MohamadDasuki/Soil_Moisture_Sensor/README.md

# Soil Moisture Sensor

Button-activated, battery-powered soil moisture meter with a 0.96" OLED display.

Press the button -> MCU wakes -> load switch powers the OLED and sensor -> moisture reading is shown for 15 s -> everything powers down (<1 uA standby).

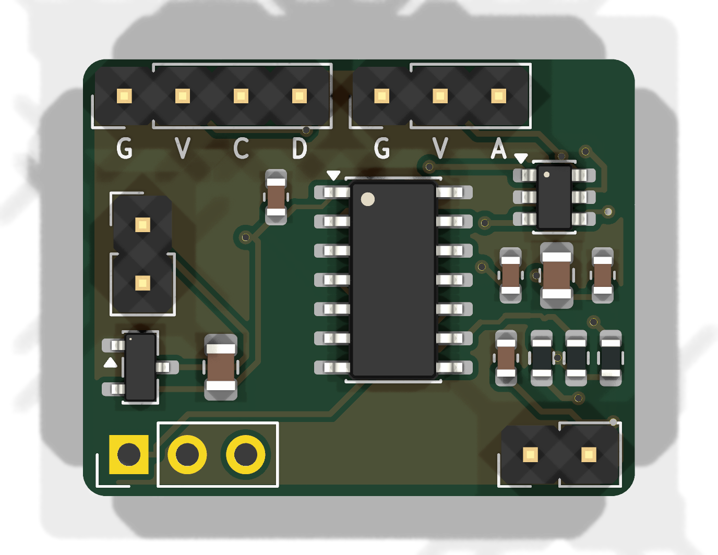
[picture p1: docs/pcb_top.png]
PCB top


## Hardware
| Ref | Function | Part |
|---|---|---|
| U1 | MCU | Microchip ATtiny1614-SSNR (SOIC-14) |
| J5 | Battery | 3xAAA holder, leads soldered to J5 pads (+ = pin 1; direct, 3.0-4.8 V) |
| Q1 | Reverse-polarity protection | AOS AO3401A P-FET |
| U2 | Peripheral power switch | TI TPS22917DBVR load switch |
| J2 | Display | ELEGOO 0.96" SSD1306 I2C OLED (0x3C) - 2.54 mm pads, GND-VCC-SCL-SDA |
| J3 | Sensor | DIYmall capacitive soil sensor v1.2 (analog) - 2.54 mm pads, GND-VCC-AOUT |
| SW1 | Button | Twidec PBS-110 7 mm panel-mount momentary, leads soldered to 2 pads |
| J1 | Programming | UPDI through-hole pads on the board edge (UPDI-GND-VCC) |

See `BOM.csv` for the full parts list and `Moisture_Sensor.pdf` for the schematic.

## PCB (rev C)
- 24 x 19 mm, 2-layer, 1.6 mm, all SMD on top, GND pour both sides.
- Top edge: OLED (G V C D) and sensor (G V A) pads. Bottom edge: UPDI (U G V) and button pads.
- Solder the supplied Dupont/PH cables directly to the pads (or fit 2.54 mm headers).
- No mounting holes: hold the board with a ledge/snap clips. `Moisture_Sensor.step` is provided for enclosure design.

## Programming
UPDI via a 3.3 V USB-serial adapter with a 4.7k resistor TX->UPDI, RX->UPDI ("SerialUPDI"), or an Adafruit UPDI Friend.
Arduino IDE + megaTinyCore, board ATtiny1614, programmer SerialUPDI. Remove batteries when powering from the programmer.

## Pin map (ATtiny1614)
| Signal | Port | Pin |
|---|---|---|
| LOAD_EN | PA4 | 2 |
| AOUT (sensor, ADC) | PA5 | 3 |
| BTN (wake) | PA6 | 4 |
| SDA | PB1 | 8 |
| SCL | PB0 | 9 |
| UPDI | PA0 | 10 |

## Firmware

`firmware/MoistureMeter/` contains an Arduino sketch for megaTinyCore. It uses 4.7 KB of flash and 75 B of RAM, and needs no external libraries. The SSD1306 driver in `oled.h` is buffer-less (text only).

**Operation**
- **Idle:** the MCU is in power-down and the load switch is off (well under 1 µA).
- **Press the button:** the OLED and sensor power up and the battery voltage is checked. The display then shows a live moisture % reading, refreshed every second, with a status line (DRY / OK / WET) and a bar graph. After 15 s it powers everything off.
- **Short press while on:** restarts the 15 s timer.
- **Hold 3 s while on:** starts calibration. Follow the prompts: sensor in air, press; sensor in water up to the line, press. The values are saved to EEPROM.
- **Battery below 3.1 V:** shows "BATTERY EMPTY" instead of a reading. Below 3.4 V, the header shows "LOW BAT".
- **Battery voltage:** measured by reading the internal 1.1 V reference against VDD, so no divider is needed. The sensor is read ratiometrically (ADC reference = VDD), so battery droop cancels out.

**Build and flash**
- Arduino IDE: add the board manager URL `http://drazzy.com/package_drazzy.com_index.json` and install **megaTinyCore**.
- Tools settings: Chip **ATtiny1614**, Clock **5 MHz internal**, BOD **Disabled/Disabled**, millis timer **default (not RTC)**, Programmer **SerialUPDI**.
- Run **Burn Bootloader** once (this only sets fuses), then **Upload Using Programmer**.
- With arduino-cli, use the FQBN `megaTinyCore:megaavr:atxy4:chip=1614,clock=5internal,bodmode=disabled`.

Calibration defaults are typical v1.2 values (dry ≈ 600/1023, wet ≈ 280/1023). Calibrate once per sensor for accurate readings.
## Ordering (JLCPCB)

The `fab/` folder holds everything needed to order the board:

| File | Upload as |
|---|---|
| `Moisture_Sensor_gerbers_JLCPCB.zip` | Gerber file (2 layers, 24 × 19 mm, 1.6 mm FR-4) |
| `BOM_JLCPCB.csv` | PCB Assembly → BOM (LCSC part numbers) |
| `CPL_JLCPCB.csv` | PCB Assembly → CPL (pick and place) |

- **Assembly:** top side only, SMD parts only. J1, J2, J3, J5 and SW1 are hand-soldered wire pads and aren't placed.
- **Before confirming,** check pin 1 of U1, U2 and Q1 in JLCPCB's placement preview. The CPL applies the usual rotation offsets for SOT-23 and SOIC parts.
- **Regenerating:**
  - CPL and JLCPCB BOM: run `tools/gen_cpl.py` with KiCad's Python.
  - Gerbers and drill files: export with `kicad-cli pcb export gerbers` (subtract soldermask, no X2) and `kicad-cli pcb export drill` (Excellon, mm, separate PTH/NPTH).
## Enclosure

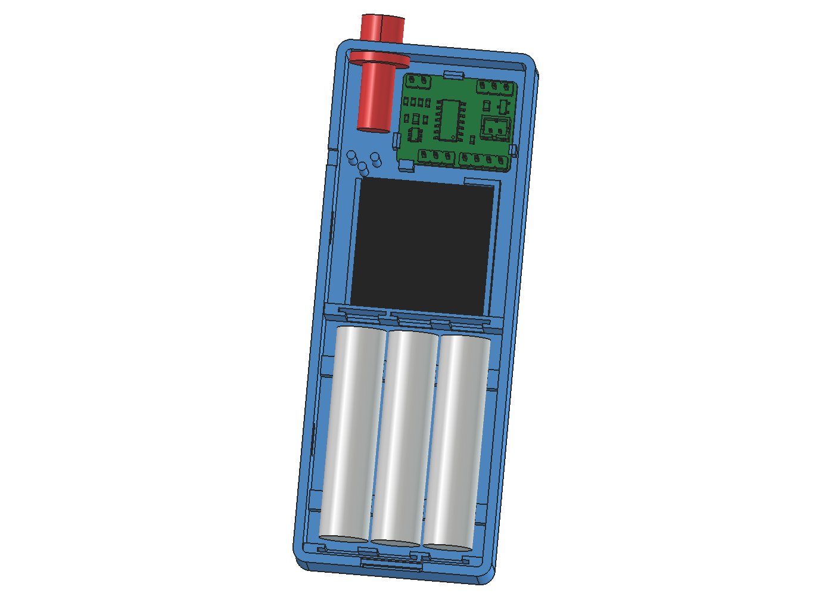
[picture p2: docs/enc_inside.png]
Inside


| | |
|---|---|
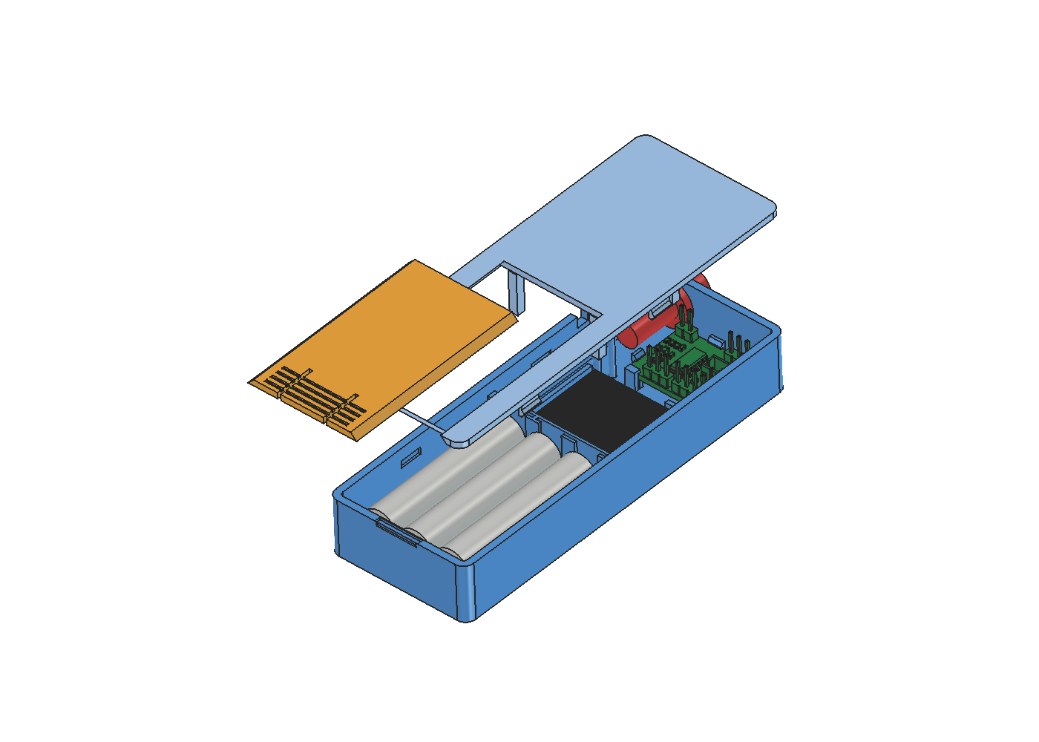
[picture p3: docs/enc_exploded.png]
Exploded
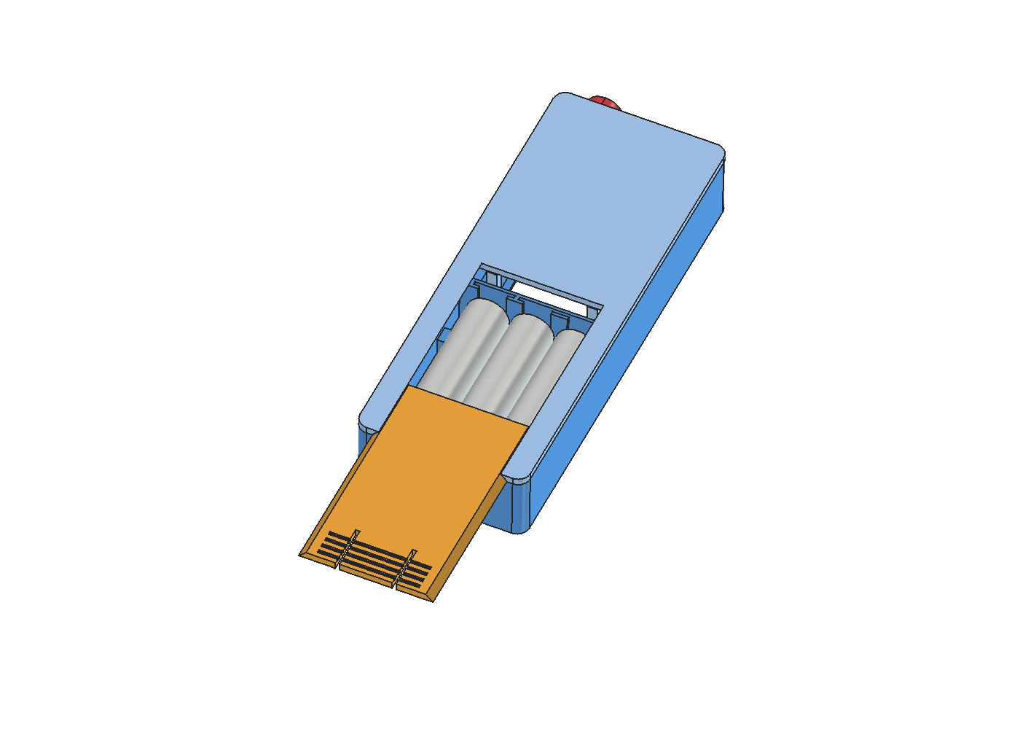
[picture p4: docs/enc_door_open.png]
Battery door
|  |  |
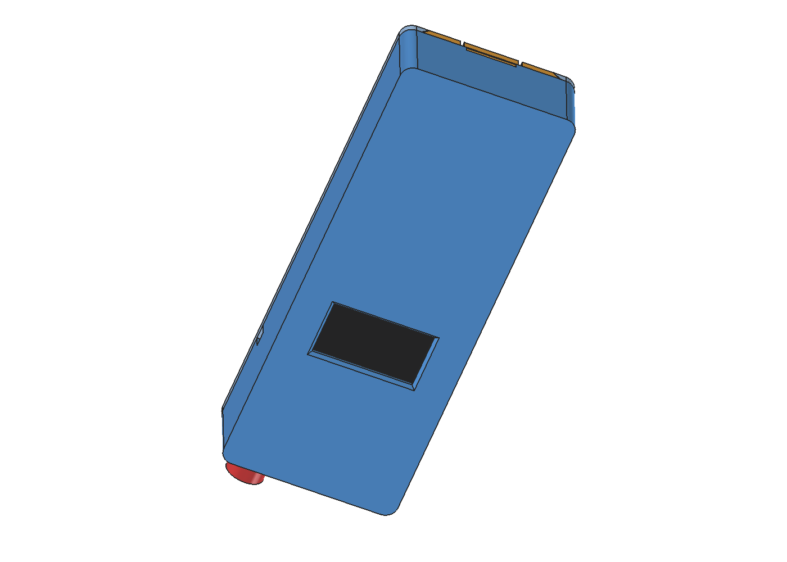
[picture p5: docs/enc_front34.png]
Front
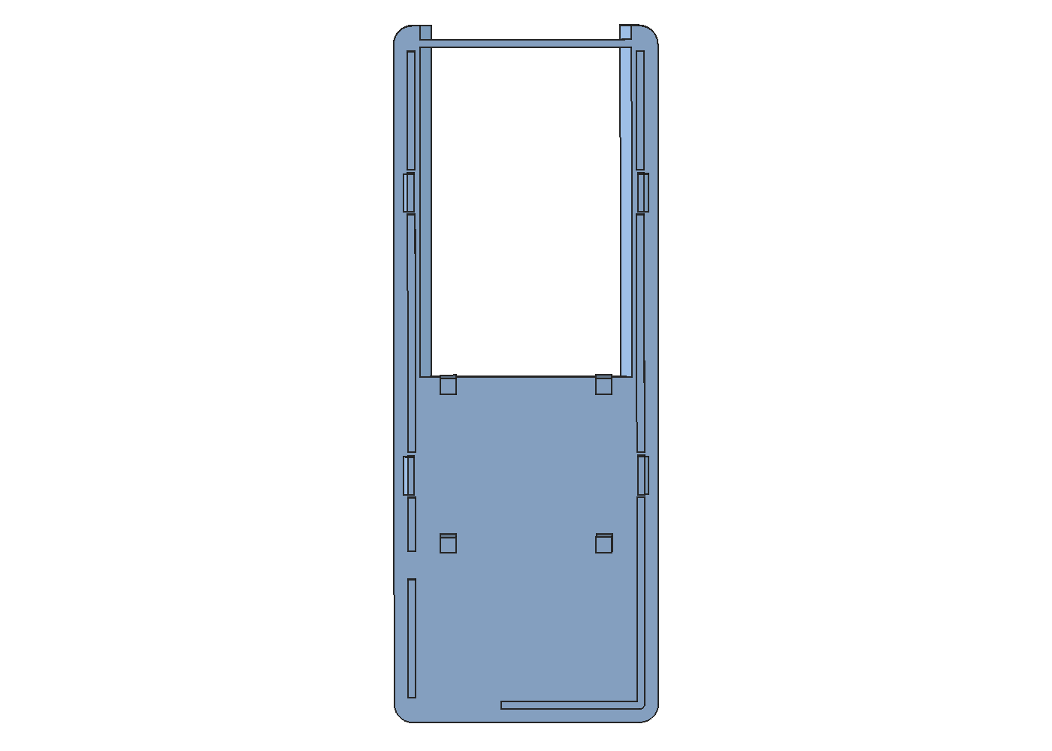
[picture p6: docs/enc_lid_under.png]
Lid underside
|  |  |

Outer size **42 × 111 × 18.4 mm**. Generated by `tools/gen_enclosure.py`, which is fully parametric (run it with FreeCAD's `freecadcmd.exe`). The script also checks for interference against the real PCB STEP model and against dummy models of the OLED, the AAA cells and the button. `tools/render_enclosure.py` (run with `freecad.exe`) regenerates the images.

| Part | File | Print orientation |
|---|---|---|
| Body (tub) | `enclosure/body.stl` | display face down, as exported |
| Lid | `enclosure/lid.stl` | outer face down, as exported |
| Battery door | `enclosure/door.stl` | outer face down, as exported |

**Printing:** no supports are needed. The button hole is a teardrop, the display window has a 45° chamfer, the clip lips overhang by 0.5 mm or less, and the door rails are 45° dovetails. Use 0.2 mm layers, 3–4 perimeters, and **PETG** (recommended for the snap clips). PLA works, but the clips run at about 3 % strain.

**Features**
- **Display:** a window in the front face. The module drops into a pocket with corner ledges, and the lid has 4 posts that clamp the module's corners.
- **PCB:** held by 3 flexible snap clips plus 1 rigid hook, on 3 mm standoffs. To insert it, tilt the board and slide its J2/J3 edge (toward the display) under the rigid hook, then press the other edge down until the clips snap.
- **Button:** a 7 mm hole in the top end wall. The nut tightens from inside.
- **Sensor cable:** a U-notch in the side wall at the lid seam, so the cable is laid in rather than threaded. Weave the cable around the 3 posts for strain relief.
- **Batteries:** 3×AAA side by side behind a sliding dovetail door. To open it, lift the flex tab at the finger grooves and slide the door out toward the bottom end.
  - Contacts are generic AAA plates/springs in 0.8 mm slots: a single plate for 10 mm-wide contacts, a double slot for 21 mm-wide bridging contacts.
  - Top fence: single (+, cell 1, left) and double (cells 2/3).
  - Bottom fence: double (cells 1/2) and single (−, cell 3).
  - Solder the + and − wires to the J5 pads (B+ / B− on the back silkscreen).
- **Lid:** snap-fit with 4 tabs; no screws. Open it only for programming (the UPDI pads are reachable with the lid off).

**Verify before printing** (all are parameters at the top of `gen_enclosure.py`):
- OLED glass and viewing-area offsets (`GLASS_*`, `VIEW_*`).
- Button body length (the space behind the wall is about 18 mm).
- Contact plate dimensions.
- Rebuild after any change.
## Notes
- Sensor: bypass its onboard 662K LDO (the NE555 is otherwise starved at 3.3 V). Its output then scales with supply, so read it ratiometrically (ADC reference = VDD). Calibrate dry/wet values in firmware.
- OLED runs from VSW through its own LDO (3.3-5 V); no mod needed.
- Firmware: 10 MHz is fine (>2.7 V); set I2C pins high-Z before switching off VSW; low-battery cutoff ~3.3 V.
- `tools/gen_sch.py` regenerates the schematic and `tools/gen_pcb.py --route` the PCB (KiCad's bundled Python; routing needs Freerouting + Java 25).
