MohamadDasuki/Soil_Moisture_Sensor/docs/pcb_bottom.png

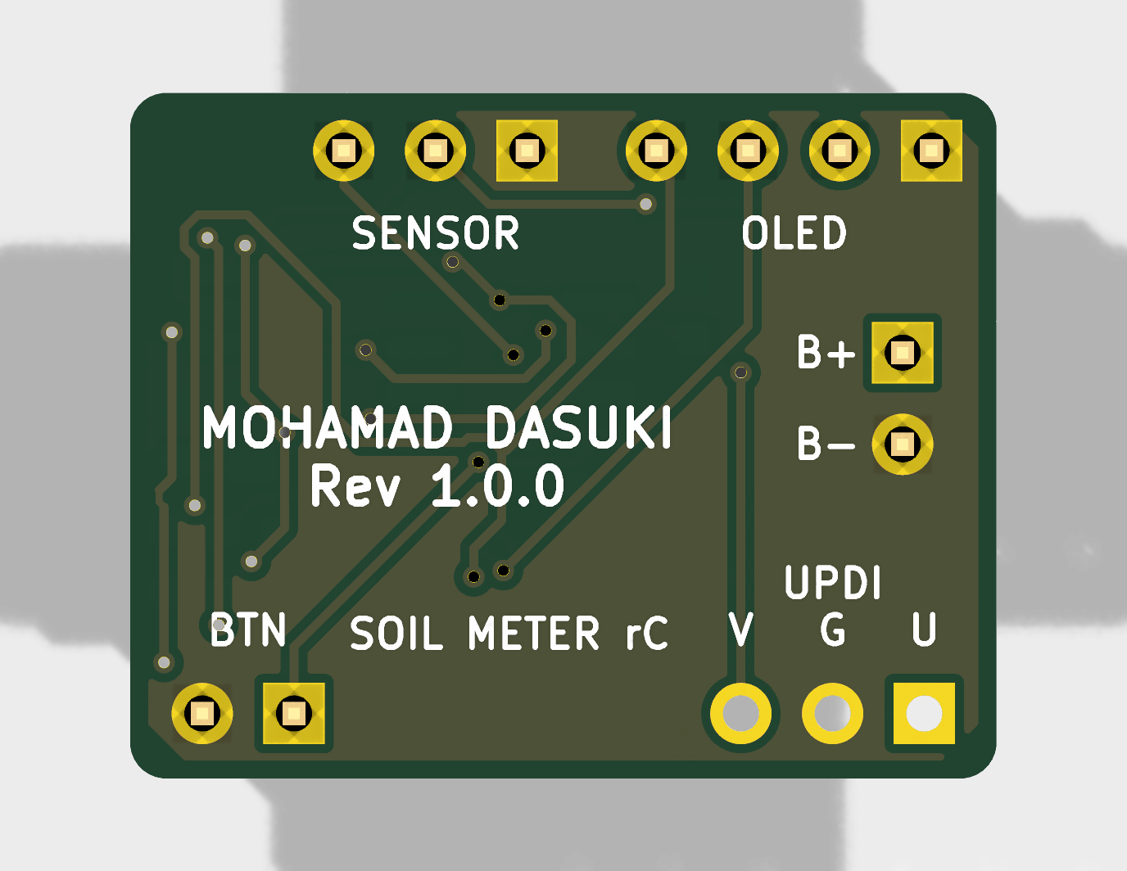
docs/pcb_bottom.png
