MohamadDasuki/Soil_Moisture_Sensor/BOM.csv

Reference | Value | Footprint | MPN | Manufacturer | LCSC | QUANTITY | DNP
C1 | 10uF 25V X5R | Capacitor_SMD:C_0805_2012Metric | CL21A106KAYNNNE | Samsung | C15850 | 1
C2,C5,C6 | 100nF | Capacitor_SMD:C_0603_1608Metric | CC0603KRX7R9BB104 | Yageo | C14663 | 3
C3 | 1nF | Capacitor_SMD:C_0603_1608Metric | CL10B102KB8NNNC | Samsung | C1588 | 1
C4 | 22uF 25V X5R | Capacitor_SMD:C_0805_2012Metric | CL21A226MAQNNNE | Samsung | C45783 | 1
J1 | UPDI | Connector_PinHeader_2.54mm:PinHeader_1x03_P2.54mm_Vertical |  |  |  | 1 | DNP
J2 | OLED SSD1306 0.96in | Connector_PinHeader_2.54mm:PinHeader_1x04_P2.54mm_Vertical | Supplied Dupont wires soldered to pads (opt. 1x04 2.54mm header) | - |  | 1
J3 | SOIL SENSOR v1.2 | Connector_PinHeader_2.54mm:PinHeader_1x03_P2.54mm_Vertical | Supplied PH2.0-3P to Dupont cable soldered to pads | DIYmall |  | 1
J5 | BATTERY 3xAAA | Connector_PinHeader_2.54mm:PinHeader_1x02_P2.54mm_Vertical | 3xAAA holder leads soldered to pads | - |  | 1
Q1 | AO3401A | Package_TO_SOT_SMD:SOT-23 | AO3401A | Alpha & Omega | C15127 | 1
R1,R2 | 10k | Resistor_SMD:R_0603_1608Metric | 0603WAF1002T5E | UNI-ROYAL | C25804 | 2
R3 | 0R | Resistor_SMD:R_0603_1608Metric | 0603WAF0000T5E | UNI-ROYAL | C21189 | 1
SW1 | READ BUTTON | Connector_PinHeader_2.54mm:PinHeader_1x02_P2.54mm_Vertical | PBS-110-XBK | Twidec |  | 1
U1 | ATtiny1614-SSNR | Package_SO:SOIC-14_3.9x8.7mm_P1.27mm | ATTINY1614-SSNR | Microchip | C481364 | 1
U2 | TPS22917DBVR | Package_TO_SOT_SMD:SOT-23-6 | TPS22917DBVR | Texas Instruments | C2681320 | 1
