MohamadDasuki/Soil_Moisture_Sensor/enclosure/assembly.step

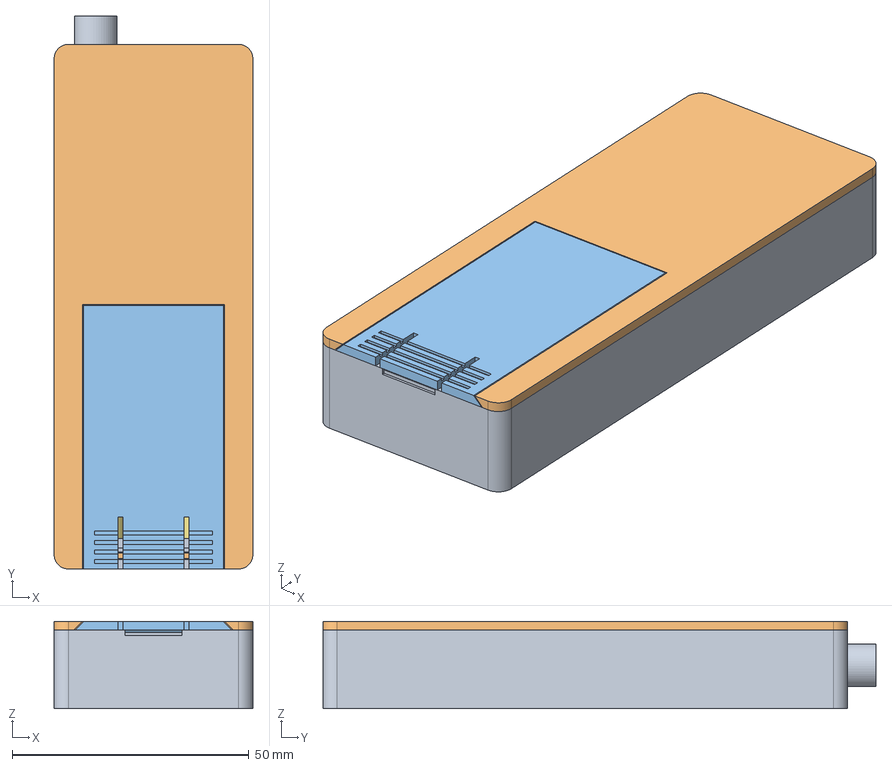
[picture p8: CAD file, 2026-10-27]
enclosure/assembly.step
42.0 x 116.9 x 18.4 mm
