MohamadDasuki/Soil_Moisture_Sensor/Moisture_Sensor.step

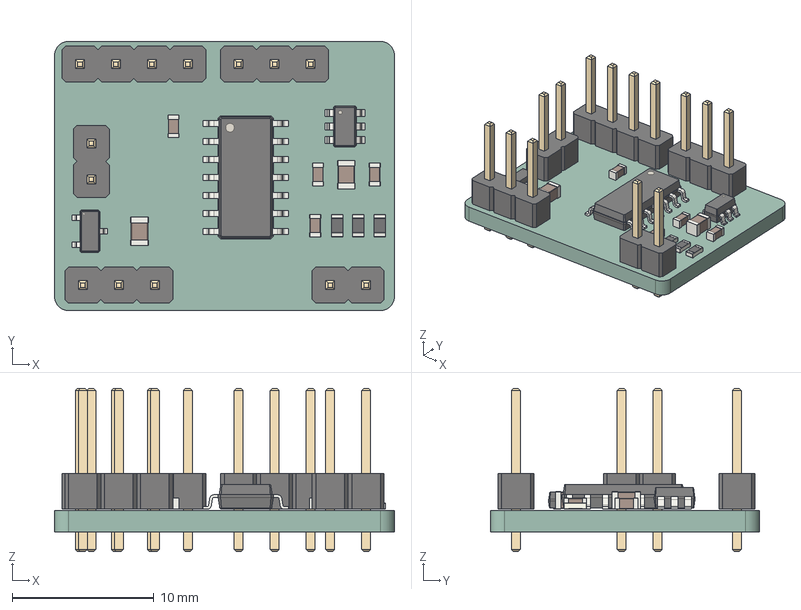
[picture p9: CAD file, 2026-10-27]
Moisture_Sensor.step
24.0 x 19.0 x 11.5 mm
SOT-23
SOIC-14_3.9x8.7mm_P1.27mm
PinHeader_1x02_P254mm_Vertical x 2
C_0603_1608Metric x 4
SOT-23-6
R_0603_1608Metric x 3
C_0805_2012Metric x 2
PinHeader_1x03_P254mm_Vertical x 2
PinHeader_1x04_P254mm_Vertical
Moisture_Sensor_PCB
