MohamadDasuki/Soil_Moisture_Sensor/enclosure/door.step

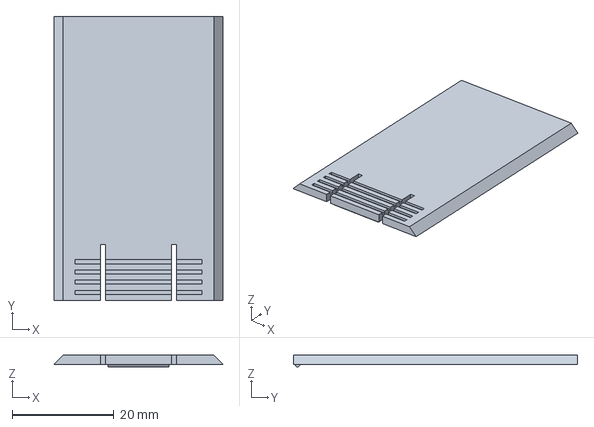
[picture p10: CAD file, 2026-10-27]
enclosure/door.step
33.1 x 55.7 x 2.30 mm
