MohamadDasuki/Soil_Moisture_Sensor/enclosure/lid.step

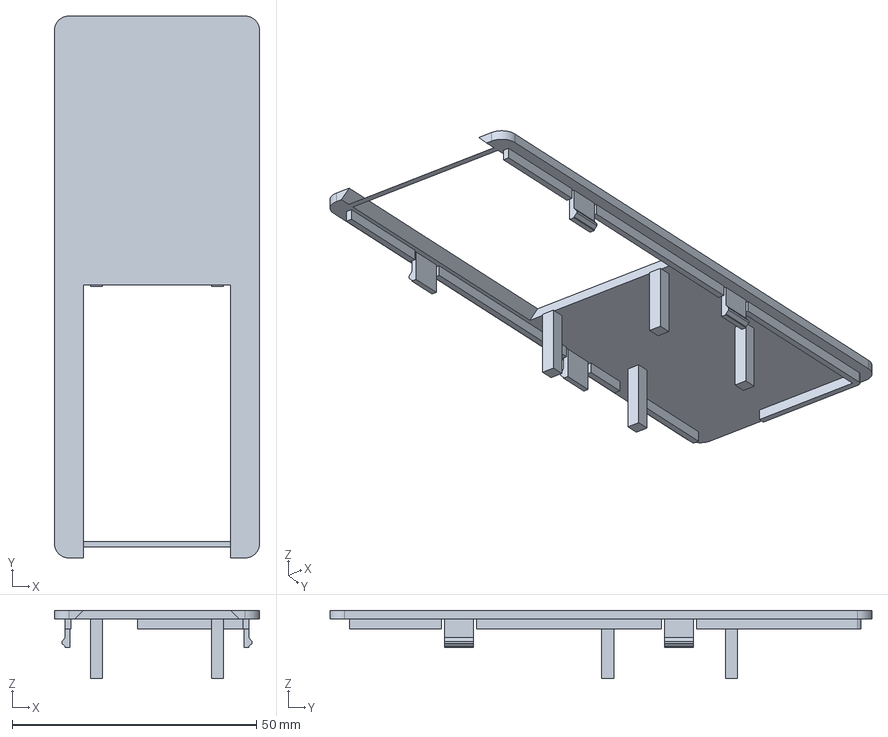
[picture p11: CAD file, 2026-10-27]
enclosure/lid.step
42.0 x 110.9 x 14.0 mm
