MohamadDasuki/Soil_Moisture_Sensor/enclosure/body.step

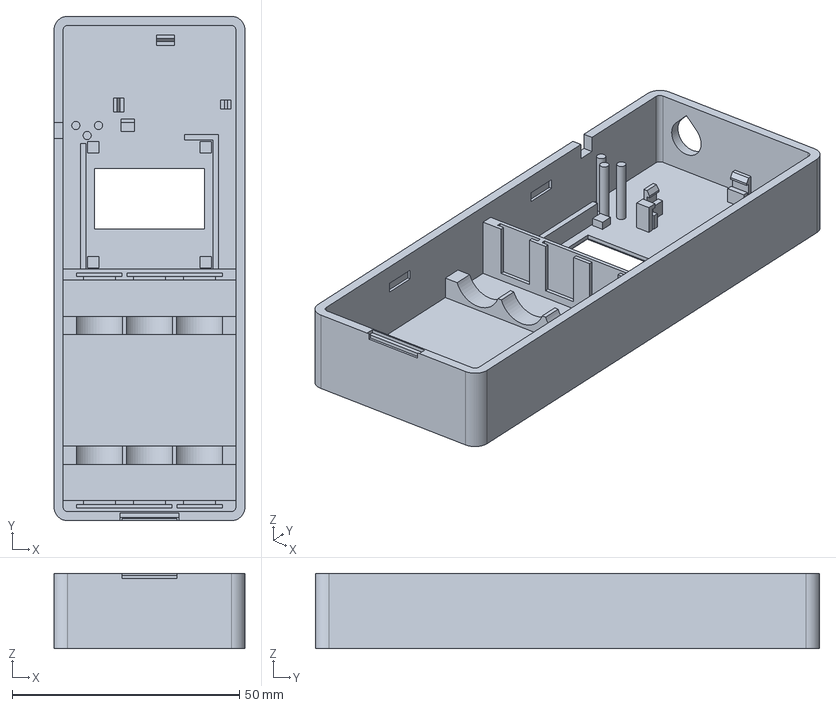
[picture p12: CAD file, 2026-10-27]
enclosure/body.step
42.0 x 110.9 x 16.6 mm
