MohamadDasuki/Soil_Moisture_Sensor/(list of files, cad)

Other CAD files:
enclosure/body.stl
enclosure/door.stl
enclosure/lid.stl
