MohamadDasuki/Soil_Moisture_Sensor/Moisture_Sensor.kicad_pcb

## KiCad design Moisture_Sensor.kicad_pcb (2026-10-27)

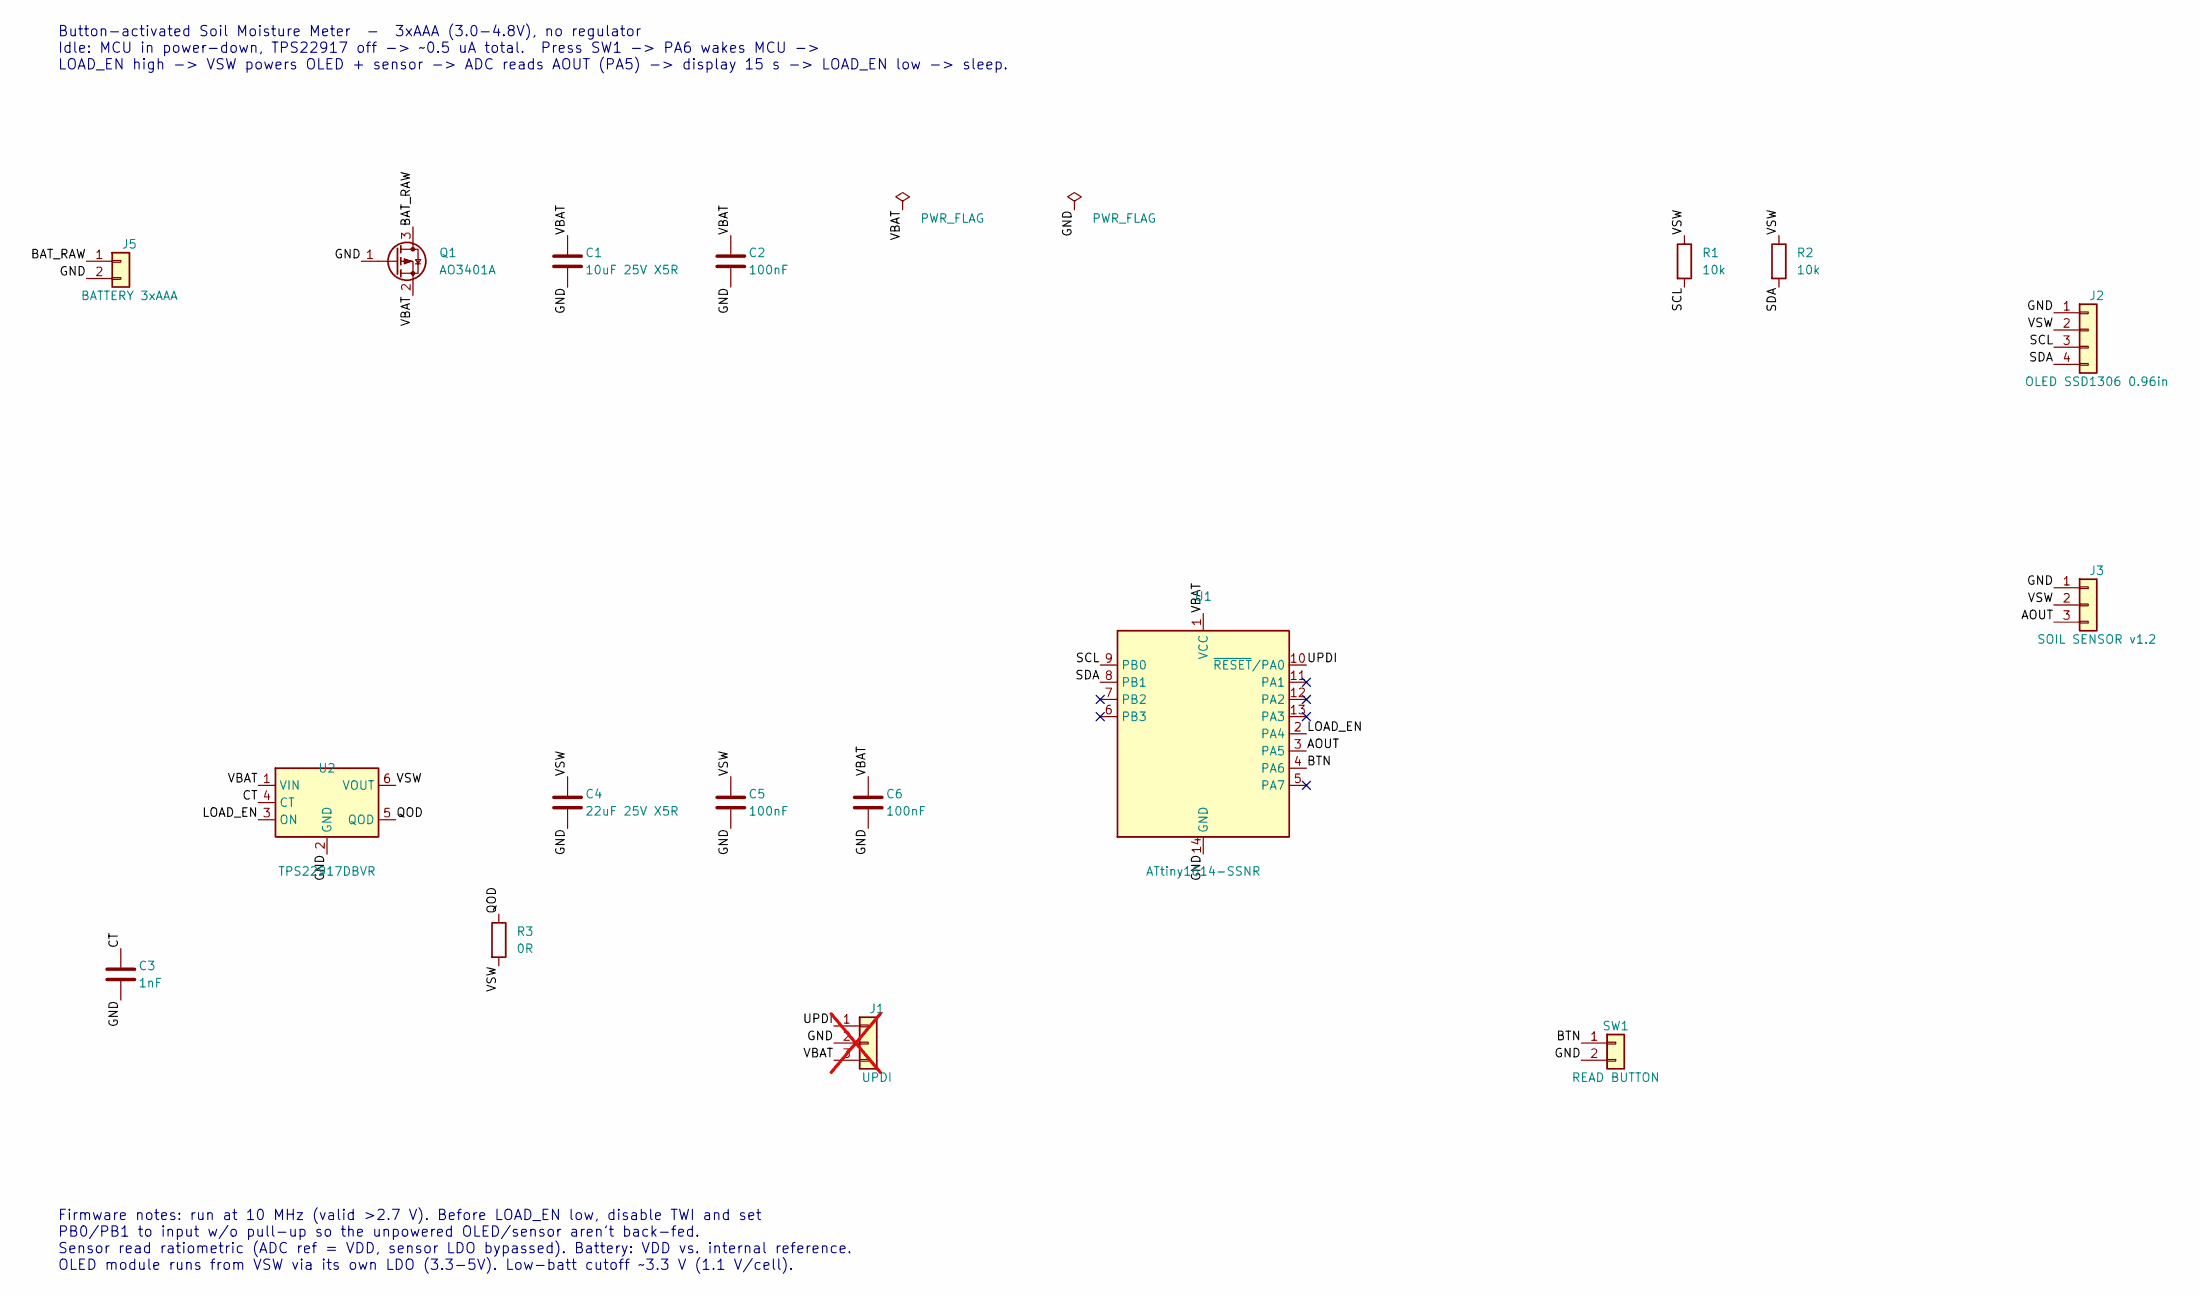
[picture p14: schematic Moisture_Sensor.kicad_sch, Soil Moisture Meter]

Parts:
C1: 10uF 25V X5R; C_0805_2012Metric; MPN CL21A106KAYNNNE; LCSC C15850
C2, C5, C6: 100nF; C_0603_1608Metric; MPN CC0603KRX7R9BB104; LCSC C14663
C3: 1nF; C_0603_1608Metric; MPN CL10B102KB8NNNC; LCSC C1588
C4: 22uF 25V X5R; C_0805_2012Metric; MPN CL21A226MAQNNNE; LCSC C45783
J1: UPDI; PinHeader_1x03_P2.54mm_Vertical; not fitted
J2: OLED SSD1306 0.96in; PinHeader_1x04_P2.54mm_Vertical; MPN Supplied Dupont wires soldered to pads 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
J3: SOIL SENSOR v1.2; PinHeader_1x03_P2.54mm_Vertical; MPN Supplied PH2.0-3P to Dupont cable solde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
J5: BATTERY 3xAAA; PinHeader_1x02_P2.54mm_Vertical; MPN 3xAAA holder leads soldered to pads
Q1: AO3401A; SOT-23; MPN AO3401A; LCSC C15127
R1, R2: 10k; R_0603_1608Metric; MPN 0603WAF1002T5E; LCSC C25804
R3: 0R; R_0603_1608Metric; MPN 0603WAF0000T5E; LCSC C21189
SW1: READ BUTTON; PinHeader_1x02_P2.54mm_Vertical; MPN PBS-110-XBK
U1: ATtiny1614-SSNR; SOIC-14_3.9x8.7mm_P1.27mm; MPN ATTINY1614-SSNR; LCSC C481364
U2: TPS22917DBVR; SOT-23-6; MPN TPS22917DBVR; LCSC C2681320

Connections:
/AOUT: J3.3, U1.3 (PA5)
/BAT_RAW: J5.1, Q1.3 (D)
/BTN: SW1.1, U1.4 (PA6)
/CT: C3.1, U2.4 (CT)
/GND: C1.2, C2.2, C3.2, C4.2, C5.2, C6.2, J1.2, J2.1, J3.1, J5.2, Q1.1 (G), SW1.2, U1.14 (GND), U2.2 (GND)
/LOAD_EN: U1.2 (PA4), U2.3 (ON)
/QOD: R3.1, U2.5 (QOD)
/SCL: J2.3, R1.2, U1.9 (PB0)
/SDA: J2.4, R2.2, U1.8 (PB1)
/UPDI: J1.1, U1.10 (~RESET/PA0)
/VBAT: C1.1, C2.1, C6.1, J1.3, Q1.2 (S), U1.1 (VCC), U2.1 (VIN)
/VSW: C4.1, C5.1, J2.2, J3.2, R1.1, R2.1, R3.2, U2.6 (VOUT)

Notes on the sheet:
Button-activated Soil Moisture Meter - 3xAAA (3.0-4.8V), no regulator Idle: MCU in power-down, TPS22917 off -> ~0.5 uA total. Press SW1 -> PA6 wakes MCU -> LOAD_EN high -> VSW powers OLED + sensor -> ADC reads AOUT (PA5) -> display 15 s -> LOAD_EN low -> sleep.
Firmware notes: run at 10 MHz (valid >2.7 V). Before LOAD_EN low, disable TWI and set PB0/PB1 to input w/o pull-up so the unpowered OLED/sensor aren't back-fed. Sensor read ratiometric (ADC ref = VDD, sensor LDO bypassed). Battery: VDD vs. internal reference. OLED module runs from VSW via its own L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

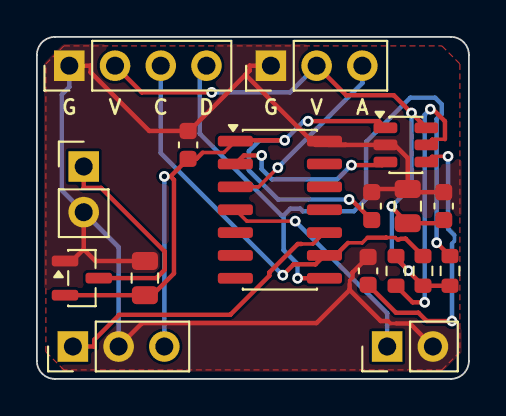
[picture p15: board Moisture_Sensor.kicad_pcb from above]

Board: 2 copper layers, 24.0 x 19.0 mm, 17 parts (0 on the bottom side), 12 nets.
