MohamadDasuki/Soil_Moisture_Sensor/(commit log)

2026-10-26 Initial schematic: button-activated soil moisture meter
    ATtiny1614, 2xAAA direct, TPS22917 load switch, SSD1306 OLED,
    Adafruit STEMMA capacitive soil sensor. Includes BOM, PDF, and
    schematic generator script.
    [BOM.csv, Moisture_Sensor.kicad_sch]
2026-10-26 Add 25x17 mm PCB layout, STEP, renders; update schematic connectors
    [BOM.csv, Moisture_Sensor.kicad_pcb, Moisture_Sensor.kicad_sch, Moisture_Sensor.step]
2026-10-26 Switch OLED connection to 2.54 mm pads matching ELEGOO module (GND-VCC-SCL-SDA)
    [BOM.csv, Moisture_Sensor.kicad_pcb, Moisture_Sensor.kicad_sch, Moisture_Sensor.step]
2026-10-26 Rev C: 3xAAA, analog soil sensor, panel button, UPDI edge pads; 24x19 mm board
    [BOM.csv, Moisture_Sensor.kicad_pcb, Moisture_Sensor.kicad_sch, Moisture_Sensor.step]
2026-10-27 Added name on board back silkscreen
    [Moisture_Sensor.kicad_pcb]
2026-10-27 Add 3D-printable enclosure (body, snap lid, sliding battery door)
    Parametric FreeCAD generator with interference check against PCB STEP,
    support-free print orientations, previews in docs/.
    [assembly.step, body.step, body.stl, door.step, door.stl, lid.step, lid.stl]
2026-10-27 Add ATtiny1614 firmware: button-wake, 15 s live reading, calibration, battery check
2026-10-27 Add JLCPCB CPL (pick-and-place) file and generator
    [CPL_JLCPCB.csv]
2026-10-27 JLCPCB BOM with LCSC part numbers; switch to JLC basic-library parts
    - Add LCSC field to all placed parts (schematic + PCB)
    - Passives -> JLC basic equivalents (C1/C4 now 25V), Q1 DMG3415U -> AO3401A (pin-compatible, basic)
    - tools/gen_cpl.py now also writes fab/BOM_JLCPCB.csv
    [BOM.csv, BOM_JLCPCB.csv, Moisture_Sensor.kicad_pcb, Moisture_Sensor.kicad_sch]
2026-10-27 Reroute PCB for 0.2 mm min track / 0.5 mm edge clearance; battery leads soldered to J5 pads
    - J5 JST-PH replaced by 2x 2.54 mm TH wire pads (B+/B- silk), removed from JLC BOM/CPL
    - gen_pcb: inset router outline for edge clearance, router clearance margin, widen necked tracks,
    solid GND connection on wire pads, preserve back-silk credit text
    - DRC 0 violations / 0 unconnected with schematic parity; enclosure re-checked (0 interferences)
    [BOM.csv, BOM_JLCPCB.csv, Moisture_Sensor.kicad_pcb, Moisture_Sensor.kicad_sch, Moisture_Sensor.step, assembly.step, body.step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]
2026-10-27 Add JLCPCB gerbers/drill package and ordering notes
    [Moisture_Sensor-B_Cu.gbl, Moisture_Sensor-B_Mask.gbs, Moisture_Sensor-B_Paste.gbp, Moisture_Sensor-B_Silkscreen.gbo, Moisture_Sensor-Edge_Cuts.gm1, Moisture_Sensor-F_Cu.gtl, Moisture_Sensor-F_Mask.gts, Moisture_Sensor-F_Paste.gtp]
